tscircuit/stall-test-levers/models/nema17/nema17_shaft_fit_coupon.step

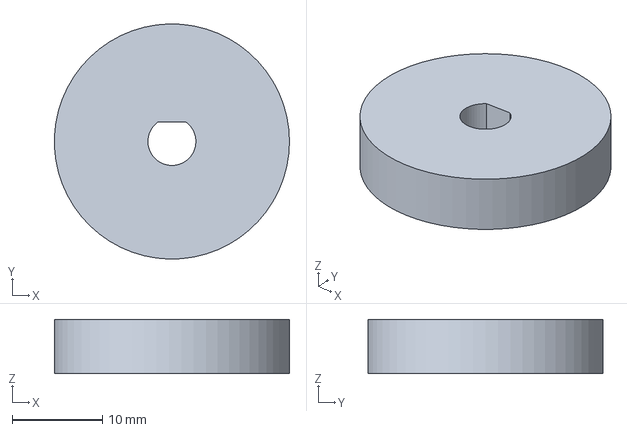
[picture p2: CAD file, 2026-10-17]
models/nema17/nema17_shaft_fit_coupon.step
26.0 x 26.0 x 6.00 mm
