tscircuit/stall-test-levers/models/nema23/nema23_stall_lever.step

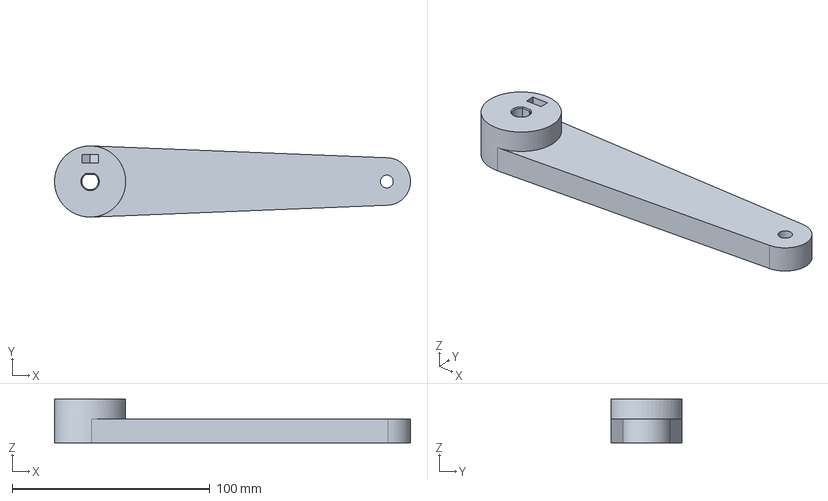
[picture p3: CAD file, 2026-10-17]
models/nema23/nema23_stall_lever.step
180.0 x 36.0 x 22.0 mm
