tscircuit/stall-test-levers/models/nema34/nema34_printed_key.step

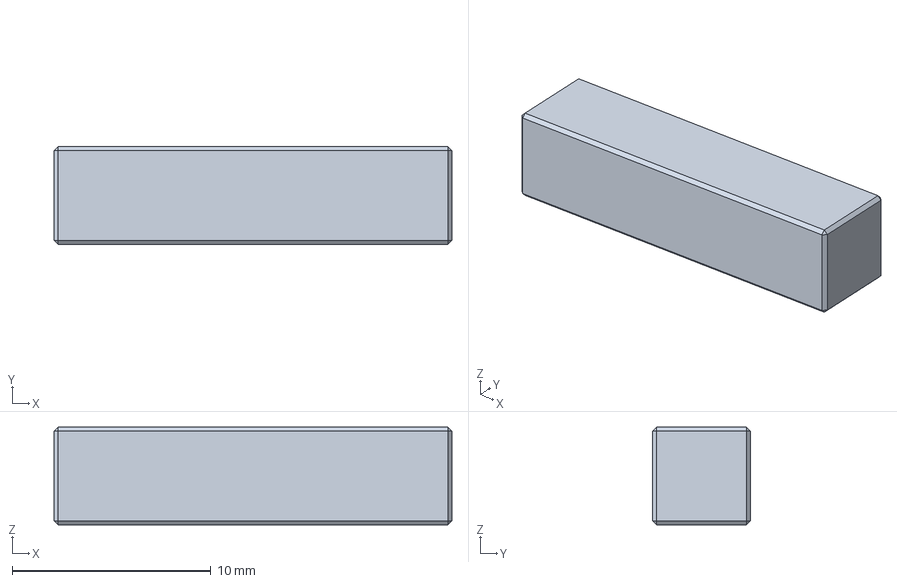
[picture p4: CAD file, 2026-10-17]
models/nema34/nema34_printed_key.step
20.0 x 4.90 x 4.90 mm
