tscircuit/stall-test-levers/models/nema34/nema34_shaft_fit_coupon.step

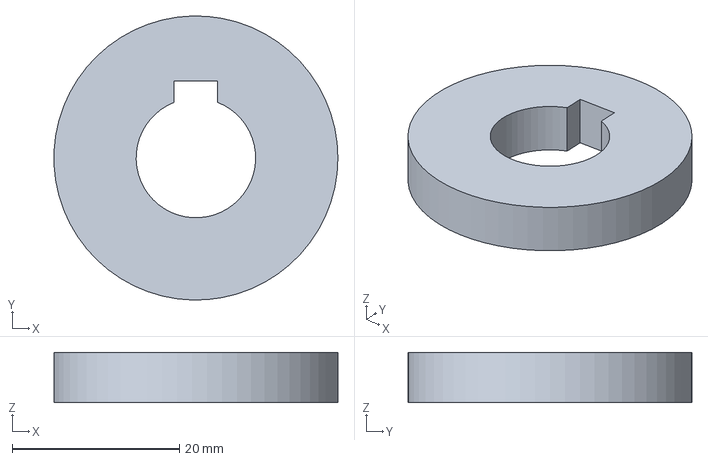
[picture p5: CAD file, 2026-10-17]
models/nema34/nema34_shaft_fit_coupon.step
34.0 x 34.0 x 6.00 mm
