tscircuit/stall-test-levers/models/nema34/nema34_stall_lever.step

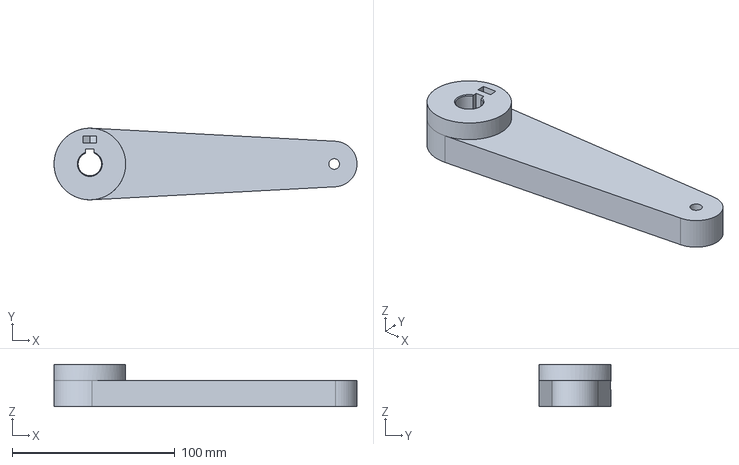
[picture p6: CAD file, 2026-10-17]
models/nema34/nema34_stall_lever.step
186.0 x 44.0 x 26.0 mm
