tscircuit/stall-test-levers/(list of files, cad)

Other CAD files:
models/nema17/nema17_stall_lever.step
models/nema23/shaft_fit_coupon.step
models/nema17/nema17_shaft_fit_coupon.stl
models/nema17/nema17_stall_lever.stl
models/nema23/nema23_stall_lever.stl
models/nema23/shaft_fit_coupon.stl
models/nema34/nema34_printed_key.stl
models/nema34/nema34_shaft_fit_coupon.stl
models/nema34/nema34_stall_lever.stl
